NeodymiumOre/iridium-kicad-components/README.md

# kicad-iridium-component-library
Iridium component library for KiCad EDA

## Installing using fish

* Run `install.fish` script.
* set -x PATH $HOME/projects/iridium-kicad-components/symbols/ $IRIDIUM_SYMBOL_DIR
* set -x PATH $HOME/projects/iridium-kicad-components/footprints/iridium.pretty $IRIDIUM_FOOTPRINT_DIR
* set -x PATH path_to_3Dmodels_in_this_repo $IRIDIUM_3DMODEL_DIR
* Add these paths in kicad in “Preferences->Configure Paths” (add ftprnt lib as “iridium-footprints”)
