NeodymiumOre/iridium-kicad-components/3d-models/MP34DT05TR-A.stp

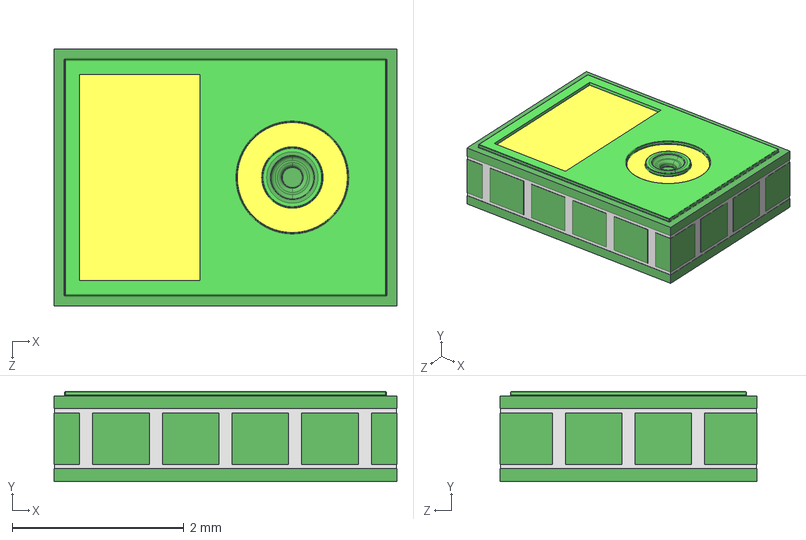
[picture p1: CAD file, 2024-03-25]
3d-models/MP34DT05TR-A.stp
4.00 x 1.05 x 3.00 mm
