NeodymiumOre/iridium-kicad-components/3d-models/LSM6DSMTR.step

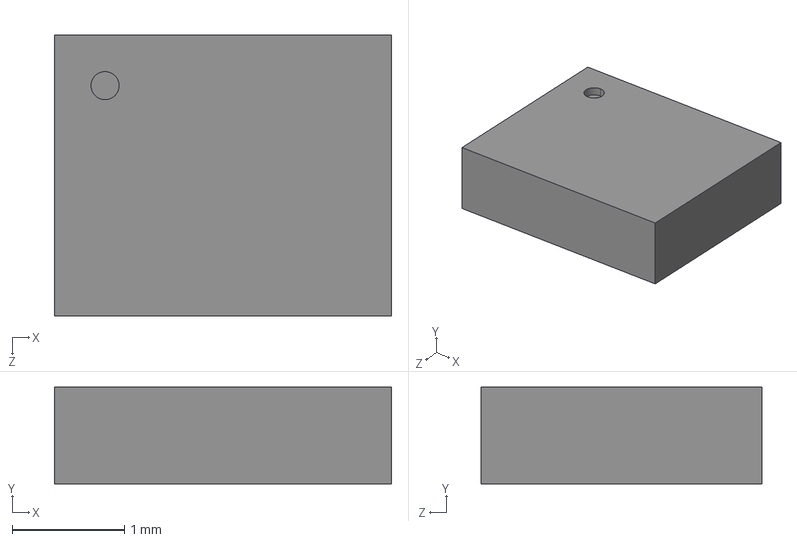
[picture p2: CAD file, 2023-09-27]
3d-models/LSM6DSMTR.step
3.00 x 0.86 x 2.50 mm
