NeodymiumOre/iridium-kicad-components/3d-models/1503_06.stp

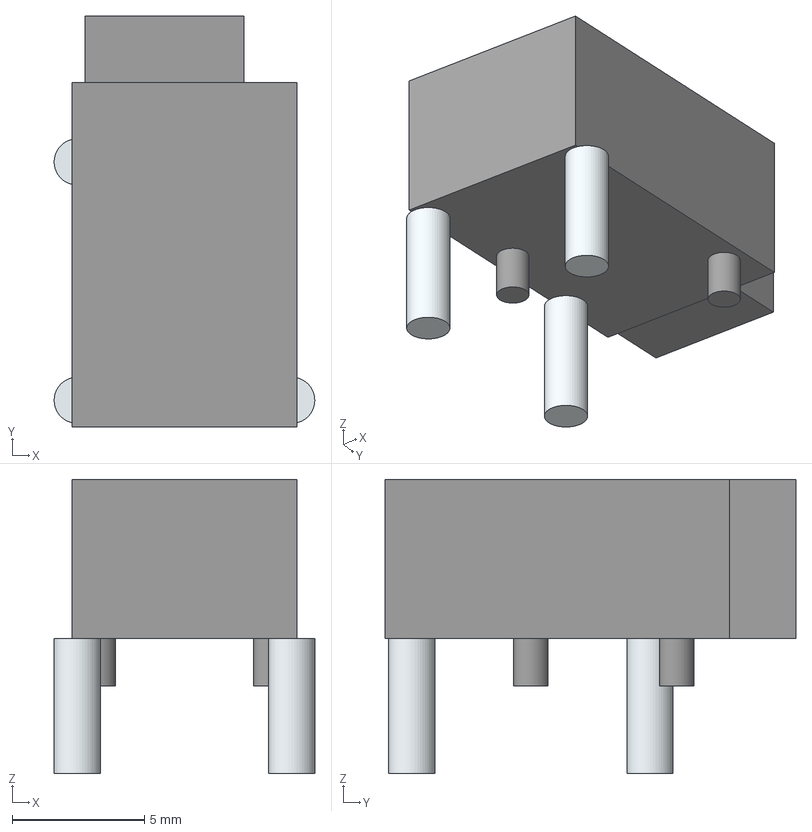
[picture p3: CAD file, 2023-09-27]
3d-models/1503_06.stp
9.84 x 15.5 x 11.1 mm
Lugs x 5
Leads x 5
