NeodymiumOre/iridium-kicad-components/3d-models/QFN50P500X500X80-33N.step

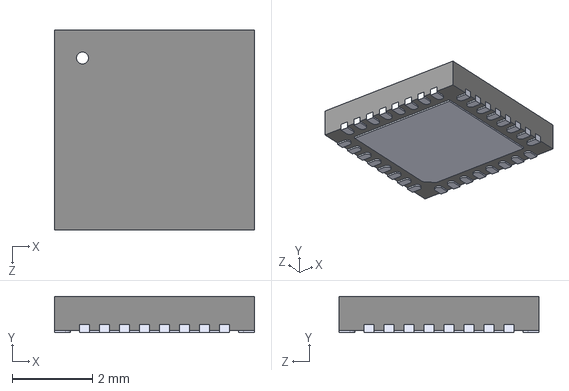
[picture p4: CAD file, 2023-09-27]
3d-models/QFN50P500X500X80-33N.step
5.00 x 0.9 x 5.00 mm
