NeodymiumOre/iridium-kicad-components/3d-models/0805-res.step

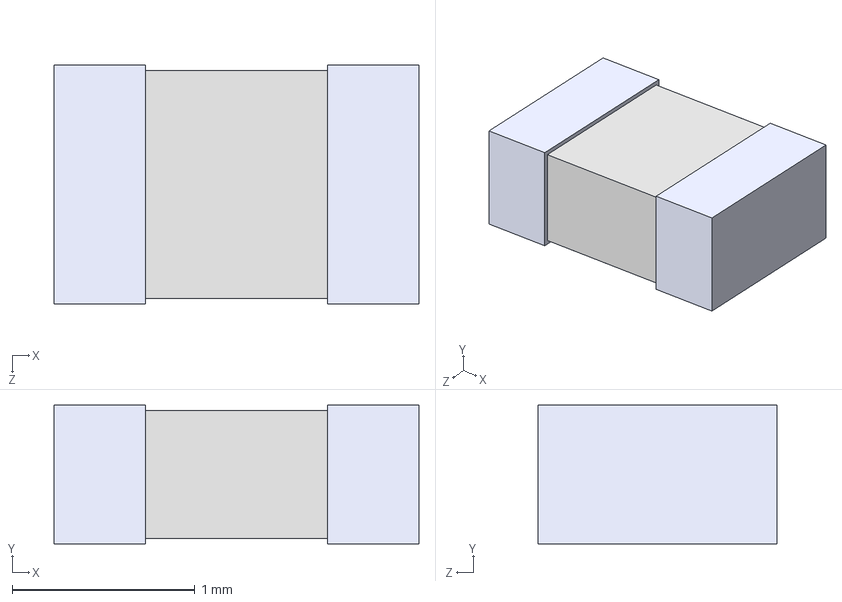
[picture p5: CAD file, 2023-09-27]
3d-models/0805-res.step
2.00 x 0.76 x 1.31 mm
