NeodymiumOre/iridium-kicad-components/3d-models/0402-cap.step

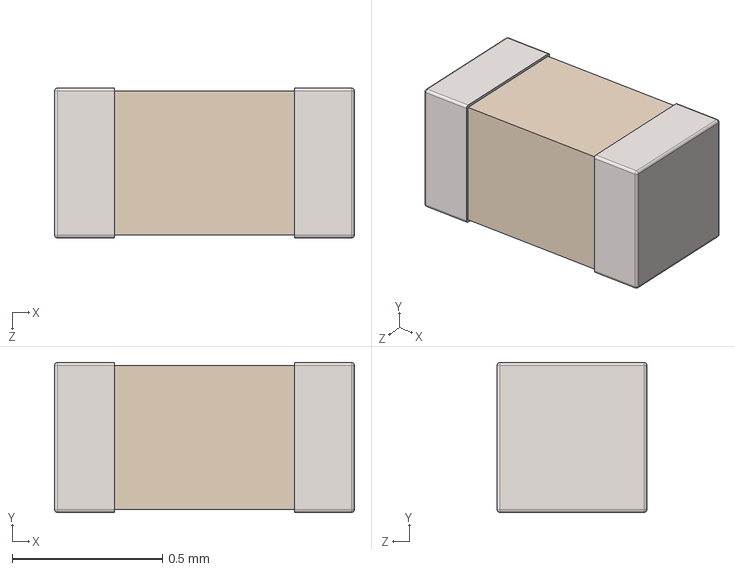
[picture p6: CAD file, 2023-09-27]
3d-models/0402-cap.step
1.00 x 0.5 x 0.5 mm
