NeodymiumOre/iridium-kicad-components/3d-models/B220-13-F.step

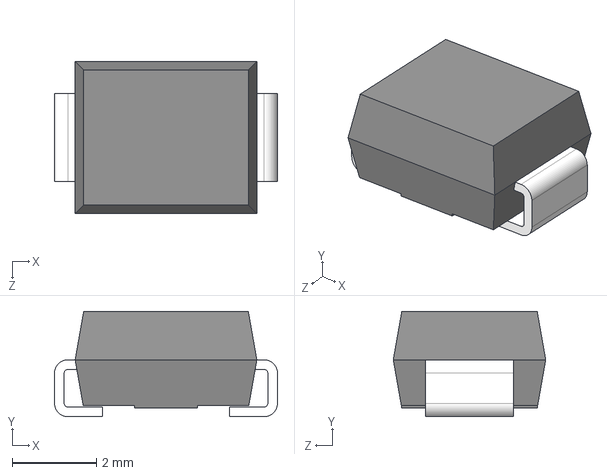
[picture p7: CAD file, 2023-09-27]
3d-models/B220-13-F.step
5.30 x 2.50 x 3.62 mm
