NeodymiumOre/iridium-kicad-components/3d-models/DE0704-220.stp

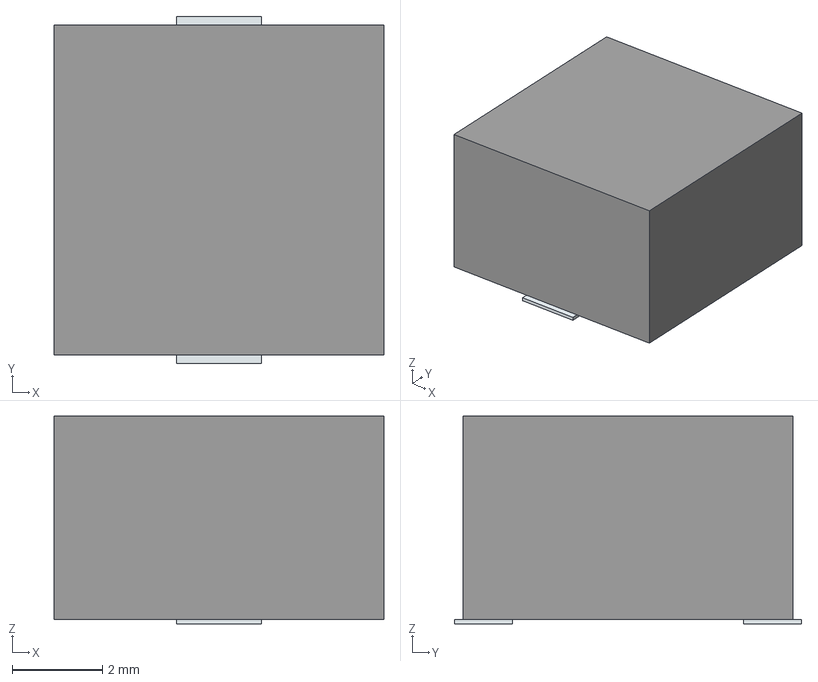
[picture p8: CAD file, 2023-09-27]
3d-models/DE0704-220.stp
7.30 x 7.68 x 4.60 mm
Pins
