NeodymiumOre/iridium-kicad-components/3d-models/USB4105-GF-A.step

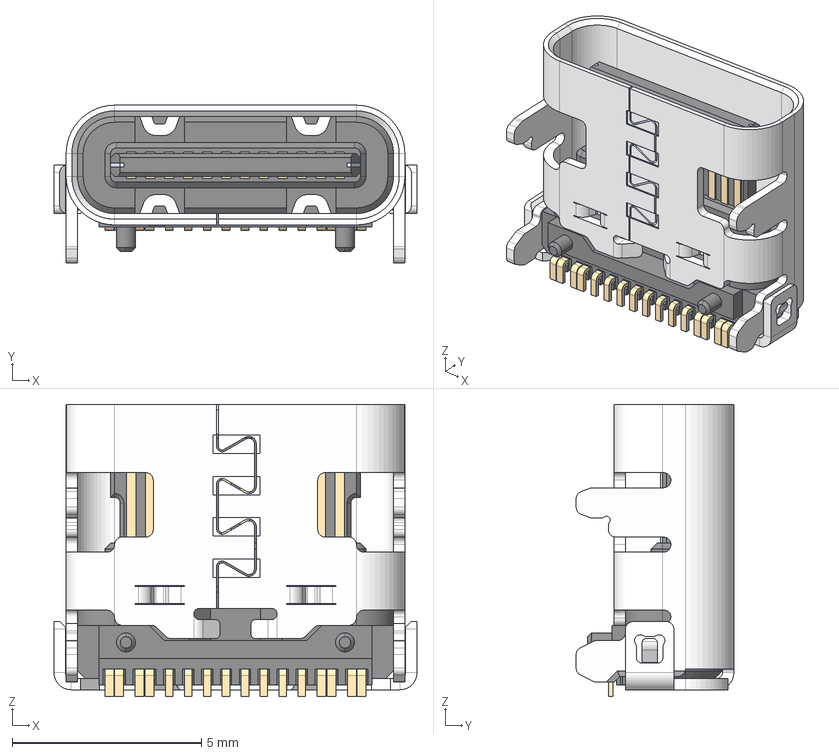
[picture p9: CAD file, 2023-09-27]
3d-models/USB4105-GF-A.step
9.58 x 4.16 x 7.71 mm
USB4105
USB4106
USB4107
USB4108
USB4109
USB4110
USB4111
USB4112
USB4113
USB4114
USB4115
USB4116
USB4117
USB4118
USB4119
USB4120
USB4121
USB4122
USB4123
USB4124
USB4125
USB4126
USB4127
USB4128
USB4129
USB4130
USB4131
USB4132
USB4133
USB4134
USB4135
USB4136
USB4137
USB4138
USB4139
USB4140
USB4141
USB4142
USB4143
USB4144
USB4145
USB4146
USB4147
USB4148
