NeodymiumOre/iridium-kicad-components/3d-models/0402-res.step

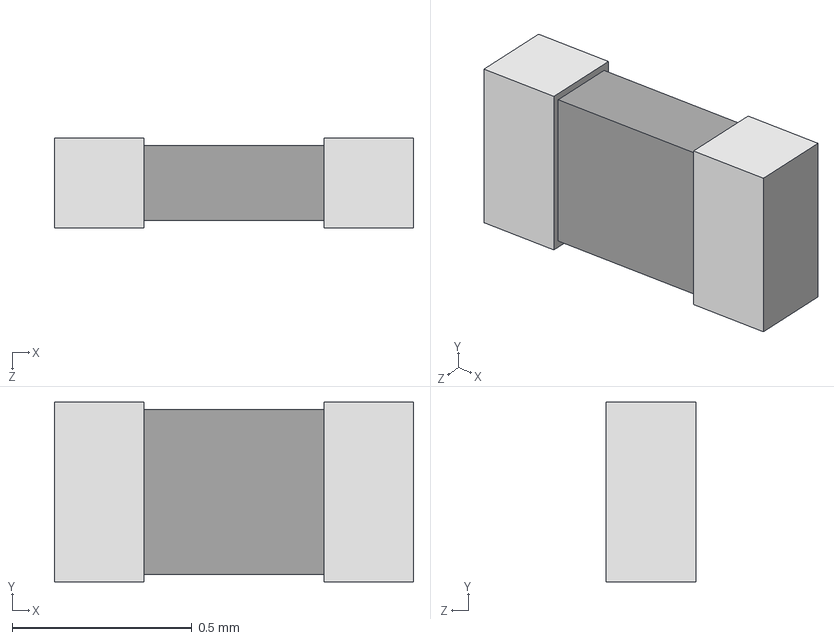
[picture p10: CAD file, 2023-09-27]
3d-models/0402-res.step
1.00 x 0.5 x 0.25 mm
