NeodymiumOre/iridium-kicad-components/3d-models/BAT_CR2032.step

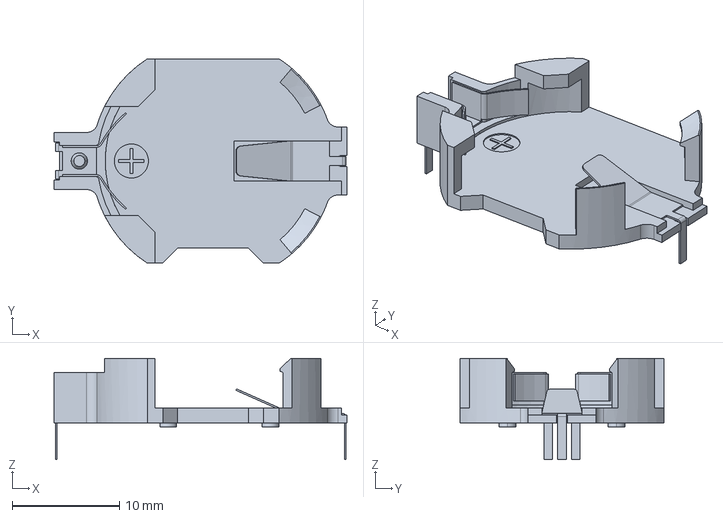
[picture p11: CAD file, 2023-09-27]
3d-models/BAT_CR2032.step
27.3 x 19.1 x 9.45 mm
