NeodymiumOre/iridium-kicad-components/3d-models/TrimmPotentiometer.step

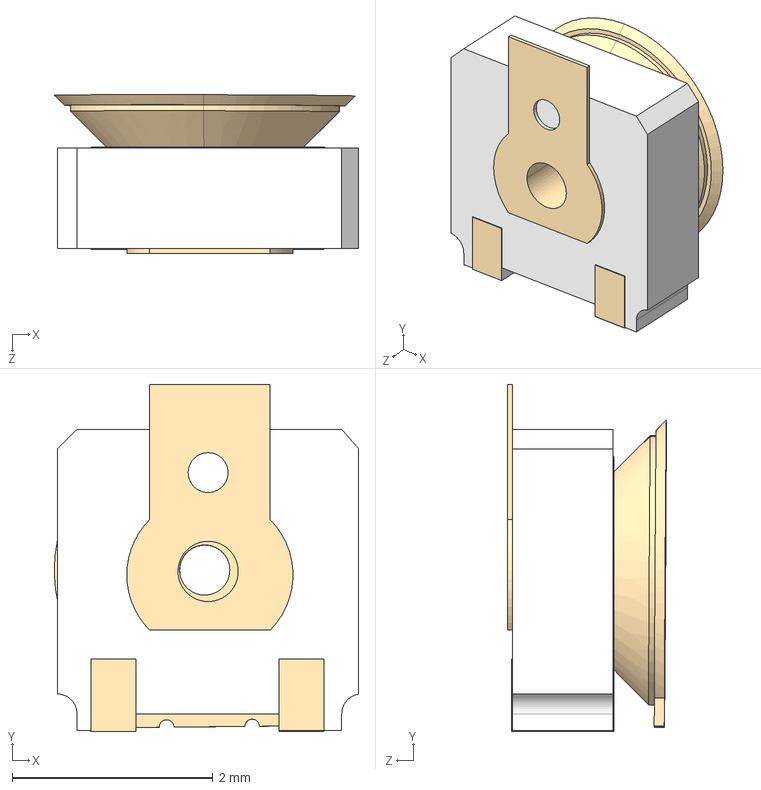
[picture p12: CAD file, 2023-09-27]
3d-models/TrimmPotentiometer.step
3.03 x 3.46 x 1.58 mm
pot1.1
pot.2
