NeodymiumOre/iridium-kicad-components/3d-models/TO220.step

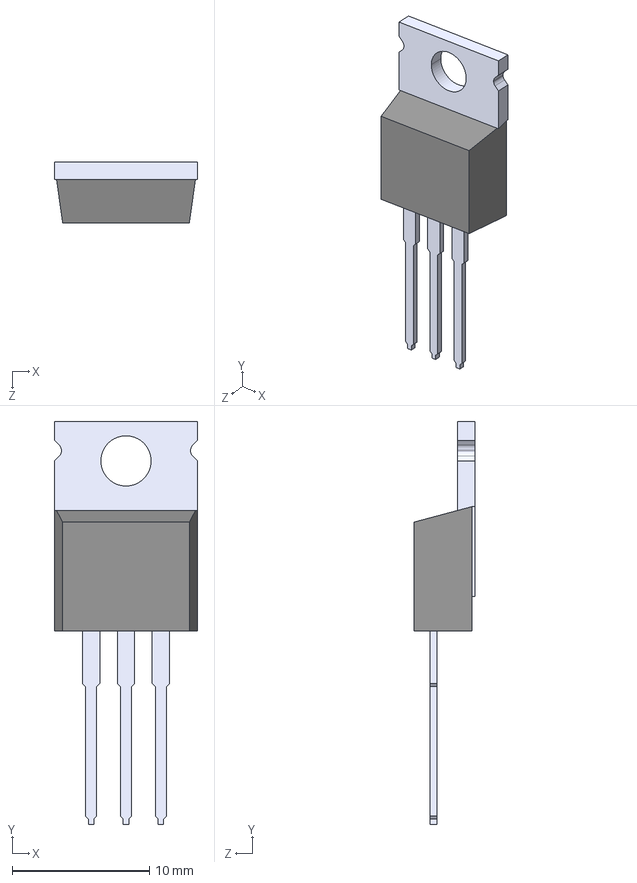
[picture p13: CAD file, 2023-09-27]
3d-models/TO220.step
10.4 x 29.3 x 4.44 mm
