NeodymiumOre/iridium-kicad-components/3d-models/TQFP-32.step

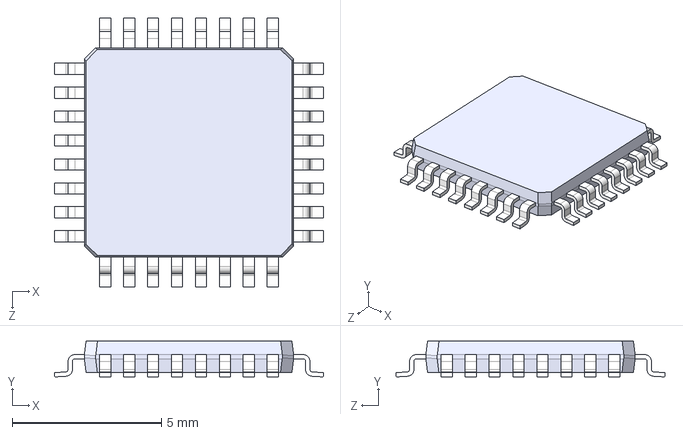
[picture p14: CAD file, 2023-09-27]
3d-models/TQFP-32.step
9.00 x 1.20 x 9.00 mm
