NeodymiumOre/iridium-kicad-components/3d-models/ACAG0301-2450-T.step

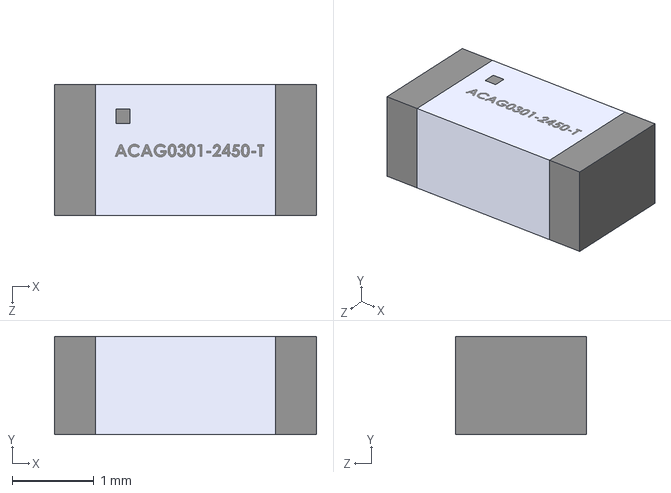
[picture p15: CAD file, 2023-09-27]
3d-models/ACAG0301-2450-T.step
3.20 x 1.20 x 1.60 mm
