NeodymiumOre/iridium-kicad-components/3d-models/0603-cap.step

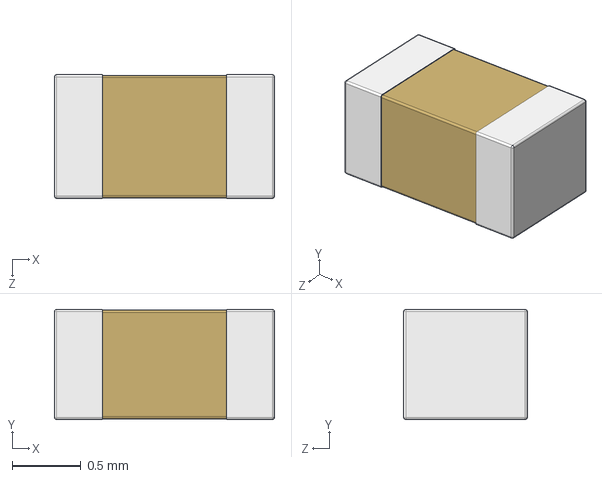
[picture p16: CAD file, 2023-09-27]
3d-models/0603-cap.step
1.60 x 0.8 x 0.9 mm
