NeodymiumOre/iridium-kicad-components/3d-models/MPU-6050.step

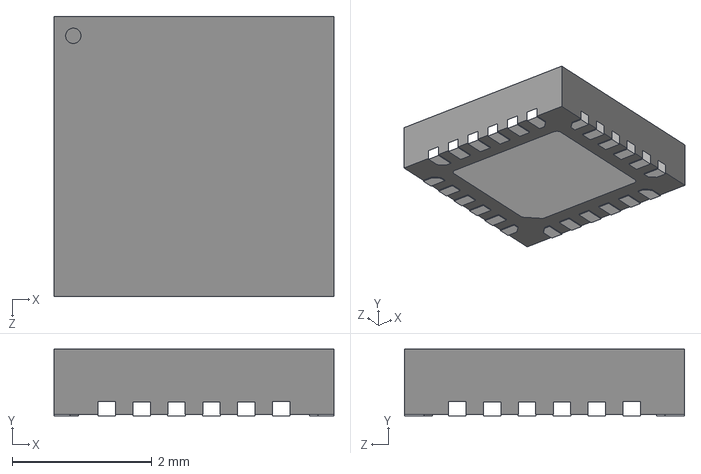
[picture p17: CAD file, 2023-09-27]
3d-models/MPU-6050.step
4.00 x 0.95 x 4.00 mm
