NeodymiumOre/iridium-kicad-components/3d-models/2-1761603-3.step

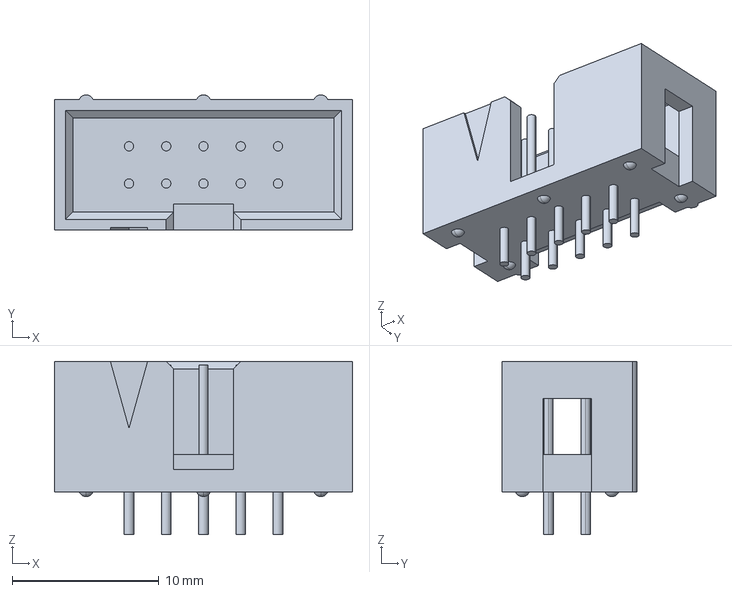
[picture p18: CAD file, 2023-09-27]
3d-models/2-1761603-3.step
20.3 x 9.22 x 11.8 mm
