NeodymiumOre/iridium-kicad-components/3d-models/0805-cap.step

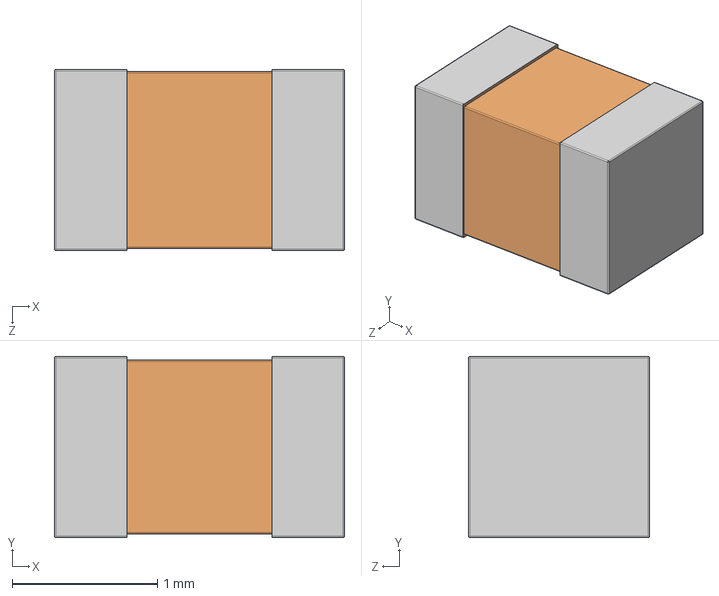
[picture p19: CAD file, 2023-09-27]
3d-models/0805-cap.step
2.00 x 1.25 x 1.25 mm
