NeodymiumOre/iridium-kicad-components/3d-models/SOIC-8.step

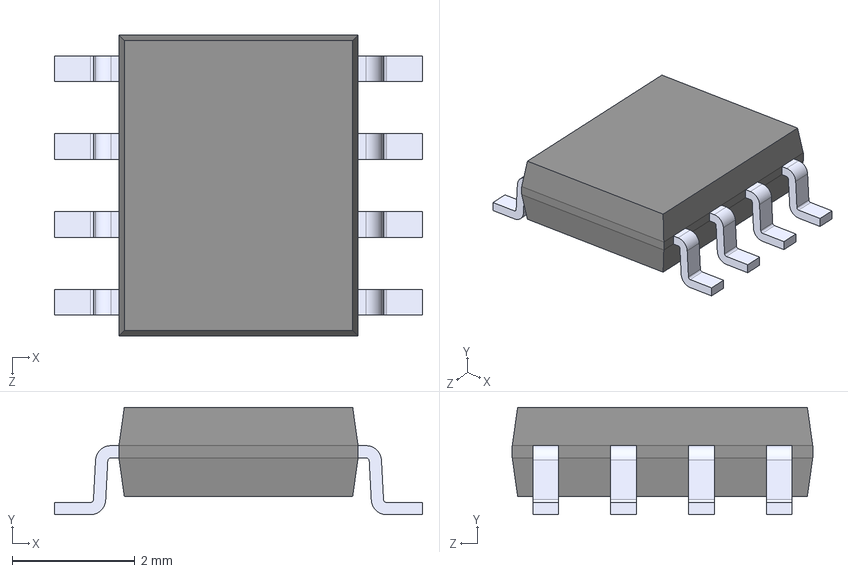
[picture p20: CAD file, 2023-09-27]
3d-models/SOIC-8.step
6.00 x 1.75 x 4.90 mm
