NeodymiumOre/iridium-kicad-components/3d-models/1503_07.stp

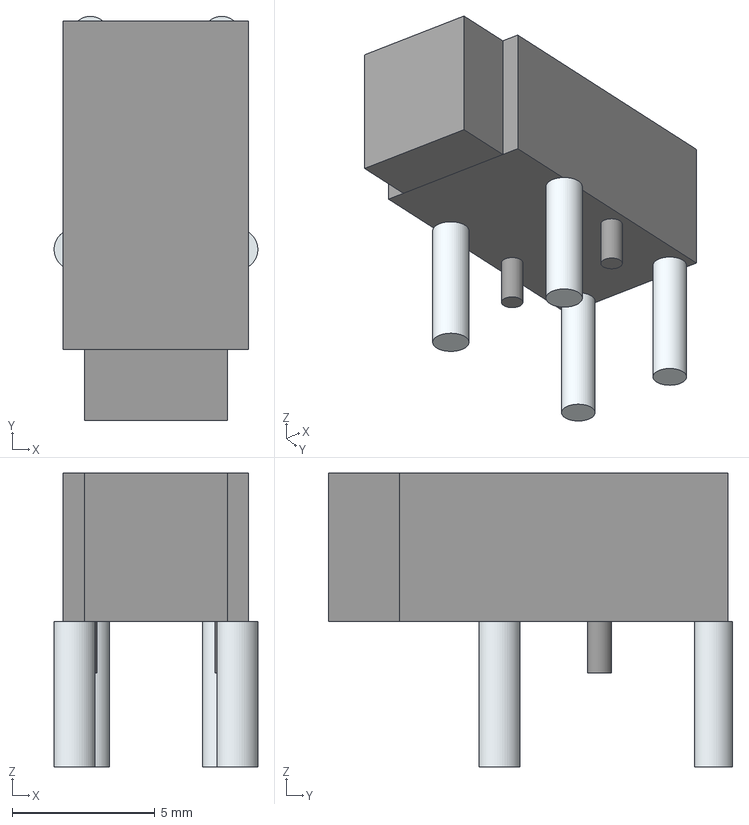
[picture p21: CAD file, 2023-09-27]
3d-models/1503_07.stp
7.14 x 14.2 x 10.3 mm
Lugs
Leads
