NeodymiumOre/iridium-kicad-components/3d-models/MR30PW-M.stp

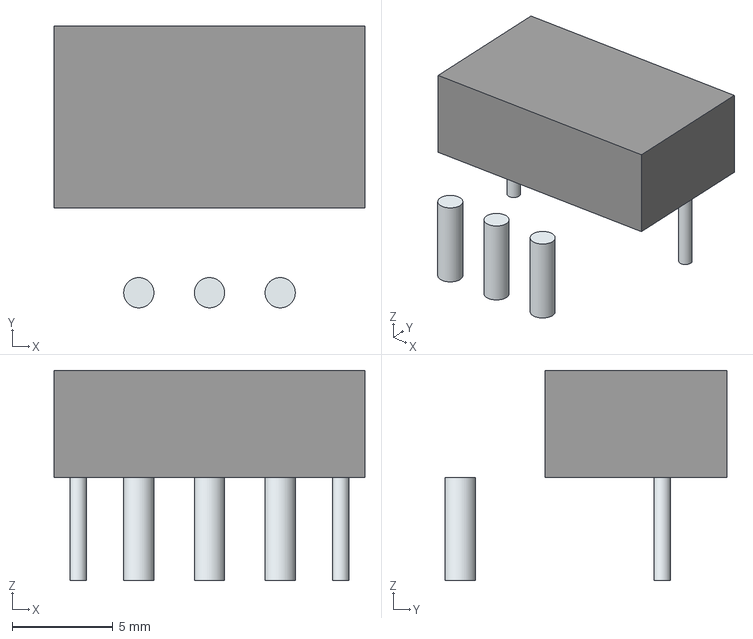
[picture p22: CAD file, 2023-09-27]
3d-models/MR30PW-M.stp
15.4 x 13.9 x 10.4 mm
Leads x 5
