NeodymiumOre/iridium-kicad-components/3d-models/ABM8W-16.3840MHZ-4-B1U-T3.stp

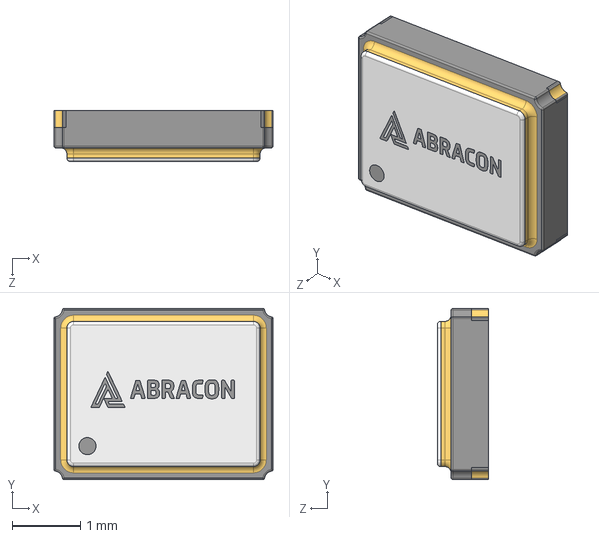
[picture p23: CAD file, 2023-09-27]
3d-models/ABM8W-16.3840MHZ-4-B1U-T3.stp
3.20 x 2.50 x 0.751 mm
ABM8W-24.0000MHZ-4-D1X-T3
Abracon New Logo
