NeodymiumOre/iridium-kicad-components/3d-models/AB38T-32.768KHZ.step

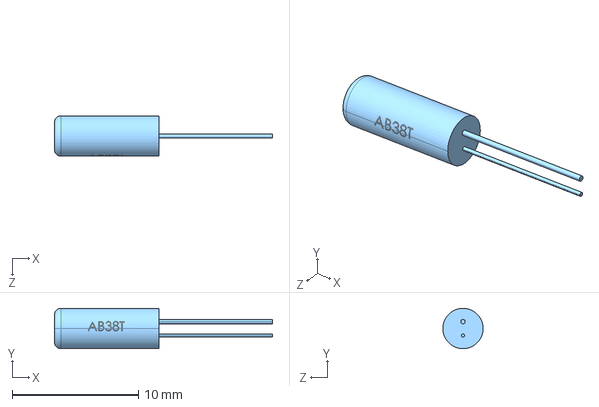
[picture p24: CAD file, 2023-09-27]
3d-models/AB38T-32.768KHZ.step
17.3 x 3.20 x 3.20 mm
