NeodymiumOre/iridium-kicad-components/3d-models/WSON8_8060_IS25LP_ISI.step

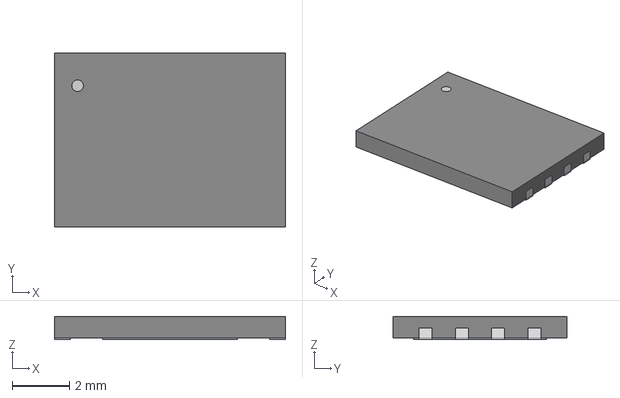
[picture p25: CAD file, 2023-09-27]
3d-models/WSON8_8060_IS25LP_ISI.step
8.10 x 6.10 x 0.815 mm
