NeodymiumOre/iridium-kicad-components/3d-models/0603-res.step

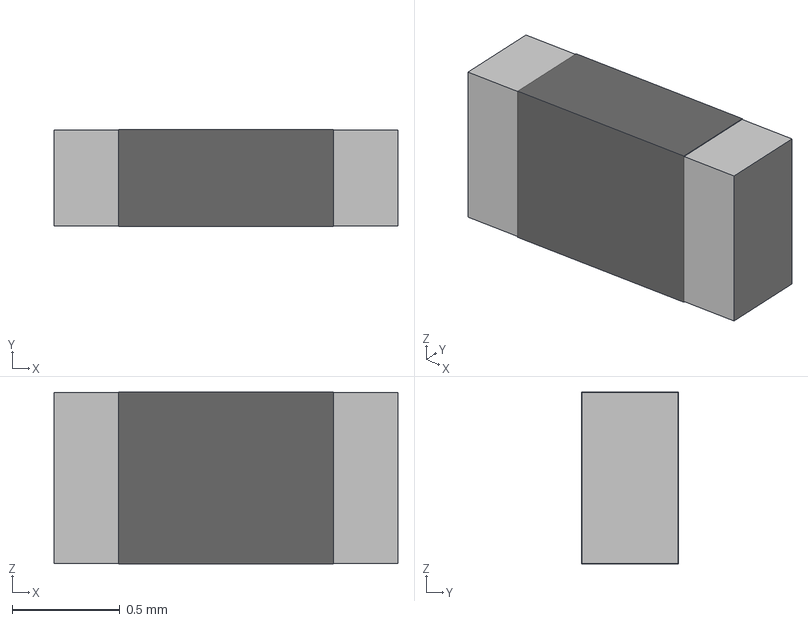
[picture p26: CAD file, 2023-09-27]
3d-models/0603-res.step
1.60 x 0.45 x 0.8 mm
