NeodymiumOre/iridium-kicad-components/3d-models/TO252-DPAK.step

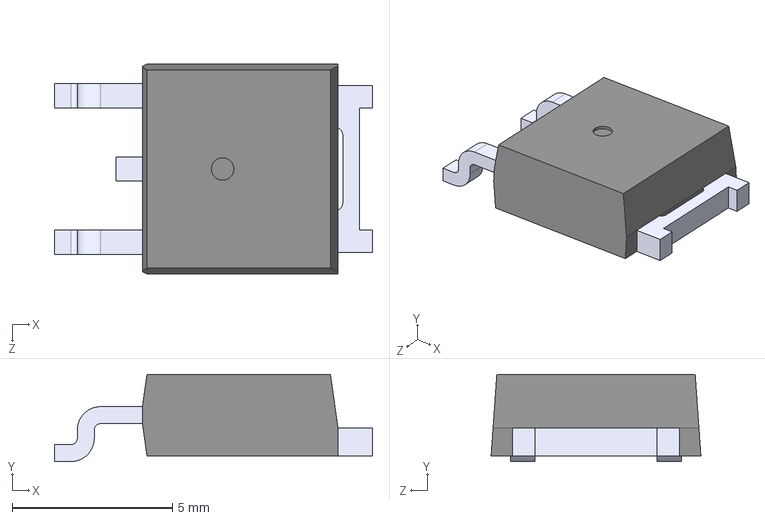
[picture p27: CAD file, 2023-09-27]
3d-models/TO252-DPAK.step
9.91 x 2.72 x 6.54 mm
