NeodymiumOre/iridium-kicad-components/3d-models/PTS636_SK43J_SMTR_LFS.stp

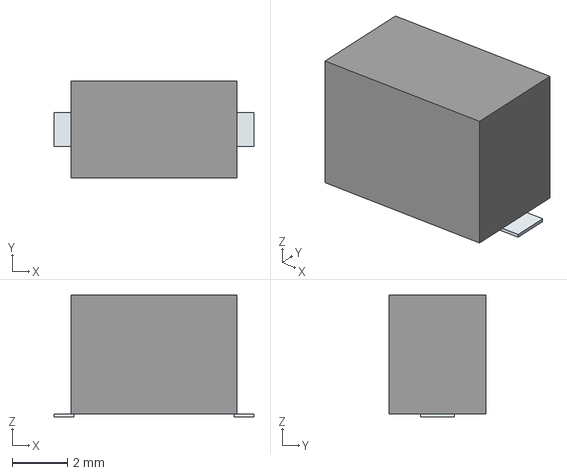
[picture p28: CAD file, 2023-09-27]
3d-models/PTS636_SK43J_SMTR_LFS.stp
7.22 x 3.50 x 4.40 mm
Pins
