NeodymiumOre/iridium-kicad-components/3d-models/ADUM240E0BRWZ.stp

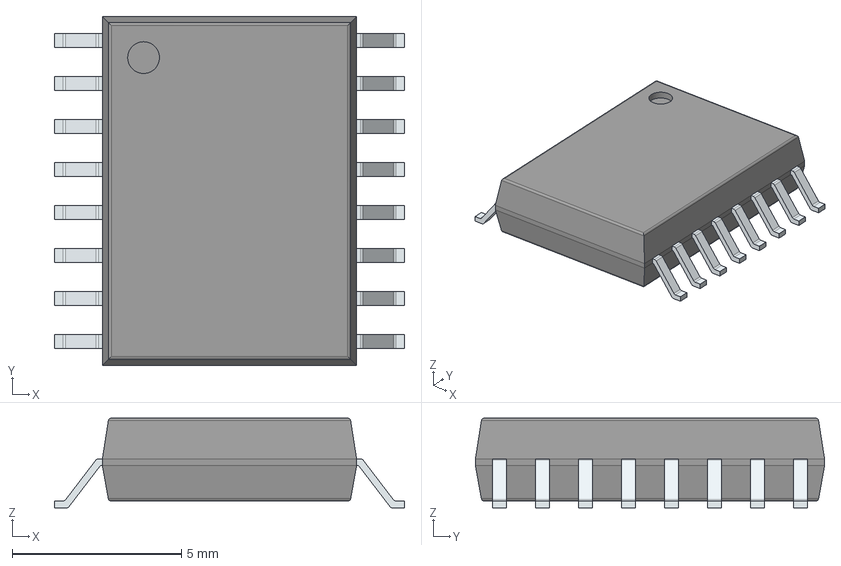
[picture p29: CAD file, 2023-09-27]
3d-models/ADUM240E0BRWZ.stp
10.3 x 10.3 x 2.65 mm
PinsArrayLR
