NeodymiumOre/iridium-kicad-components/3d-models/ABM8-40.000MHZ-10-B1X-T.stp

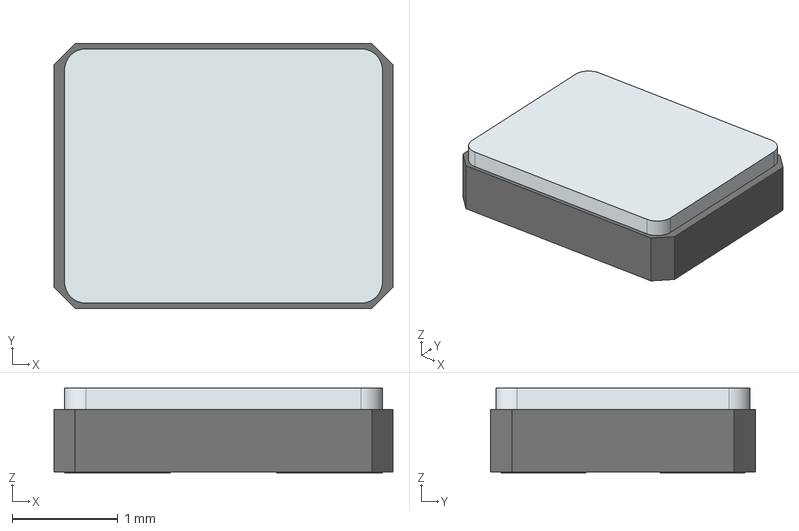
[picture p30: CAD file, 2023-09-27]
3d-models/ABM8-40.000MHZ-10-B1X-T.stp
3.20 x 2.50 x 0.8 mm
solidBody
solidLid
solidTerminal
