NeodymiumOre/iridium-kicad-components/3d-models/74HC14D_653.step

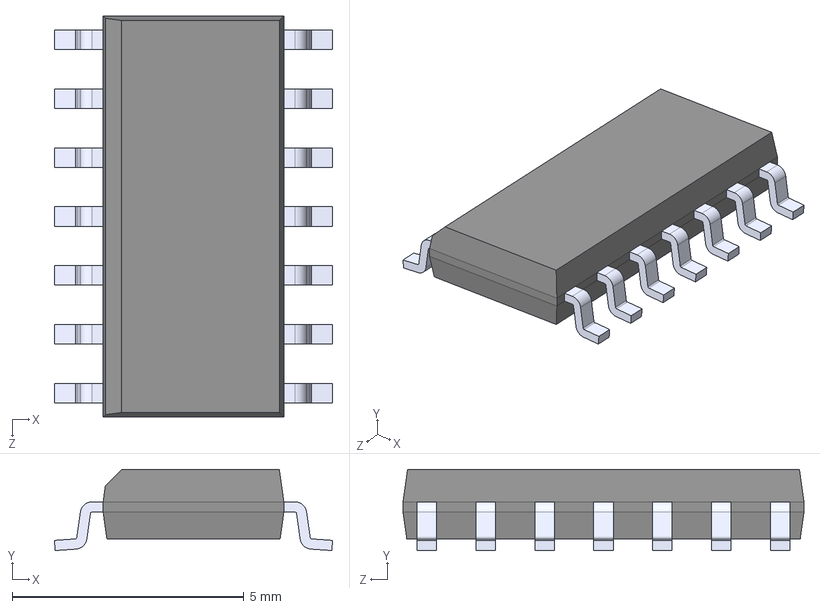
[picture p31: CAD file, 2023-09-27]
3d-models/74HC14D_653.step
6.00 x 1.75 x 8.65 mm
