NeodymiumOre/iridium-kicad-components/3d-models/MR30PW-FB.stp

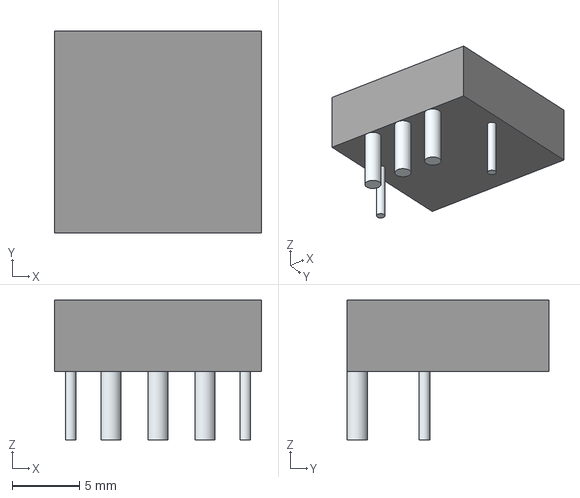
[picture p32: CAD file, 2023-09-27]
3d-models/MR30PW-FB.stp
15.4 x 15.0 x 10.4 mm
Leads
