NeodymiumOre/iridium-kicad-components/3d-models/AYZ0102AGRLC.stp

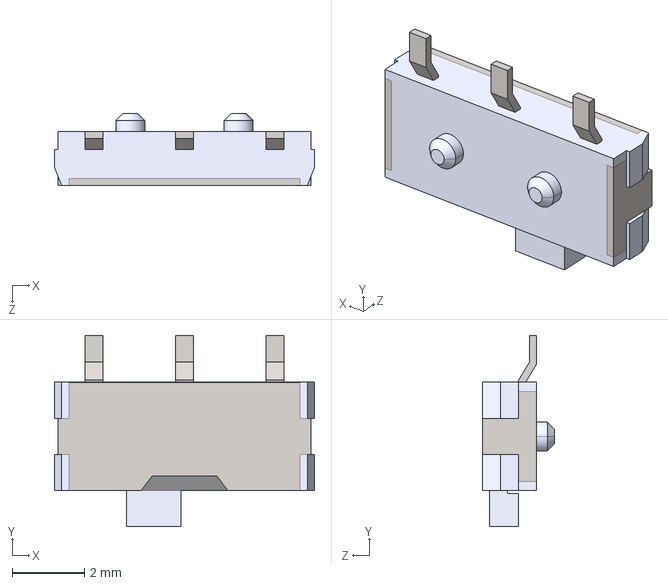
[picture p33: CAD file, 2023-09-27]
3d-models/AYZ0102AGRLC.stp
7.20 x 5.30 x 2.00 mm
