NeodymiumOre/iridium-kicad-components/(commit log)

2023-09-27 Added iridium component library in current state
    [0402-cap.step, 0402-res.step, 0603-cap.step, 0603-res.step, 0805-cap.step, 0805-res.step, 1503_06.stp, 1503_07.stp]
2024-02-20 Created iridium footprint library inside footprint dir
2024-02-20 Updated paths to 3d models in footprints
2024-02-20 Assigned 3d models to some footprints
2024-03-25 Added MP34DT05TR-A component
    [MP34DT05TR-A.stp]
